NailsonChagas/EEG/imgs_slide/kicaf_canal.jpeg

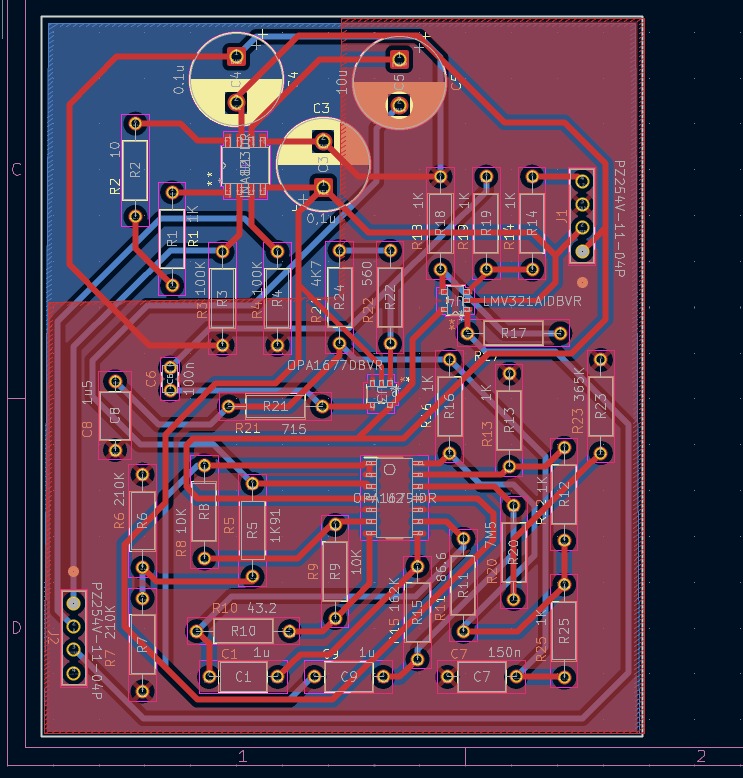
imgs_slide/kicaf_canal.jpeg
