NailsonChagas/EEG/imgs_slide/easyeda_canal.jpeg

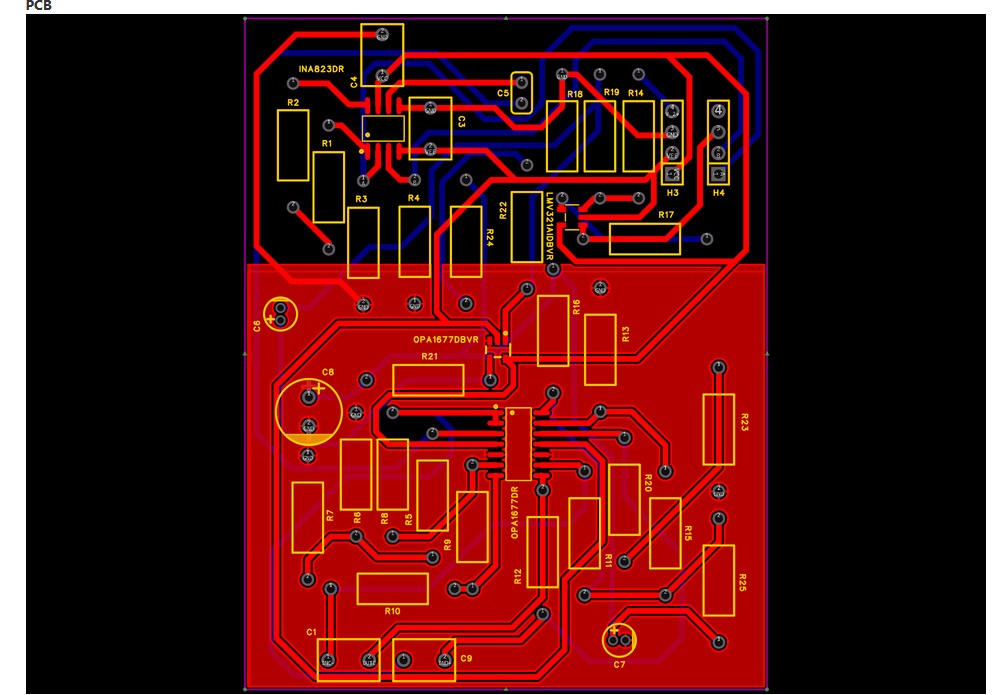
imgs_slide/easyeda_canal.jpeg
