NailsonChagas/EEG/EEG.drawio.png

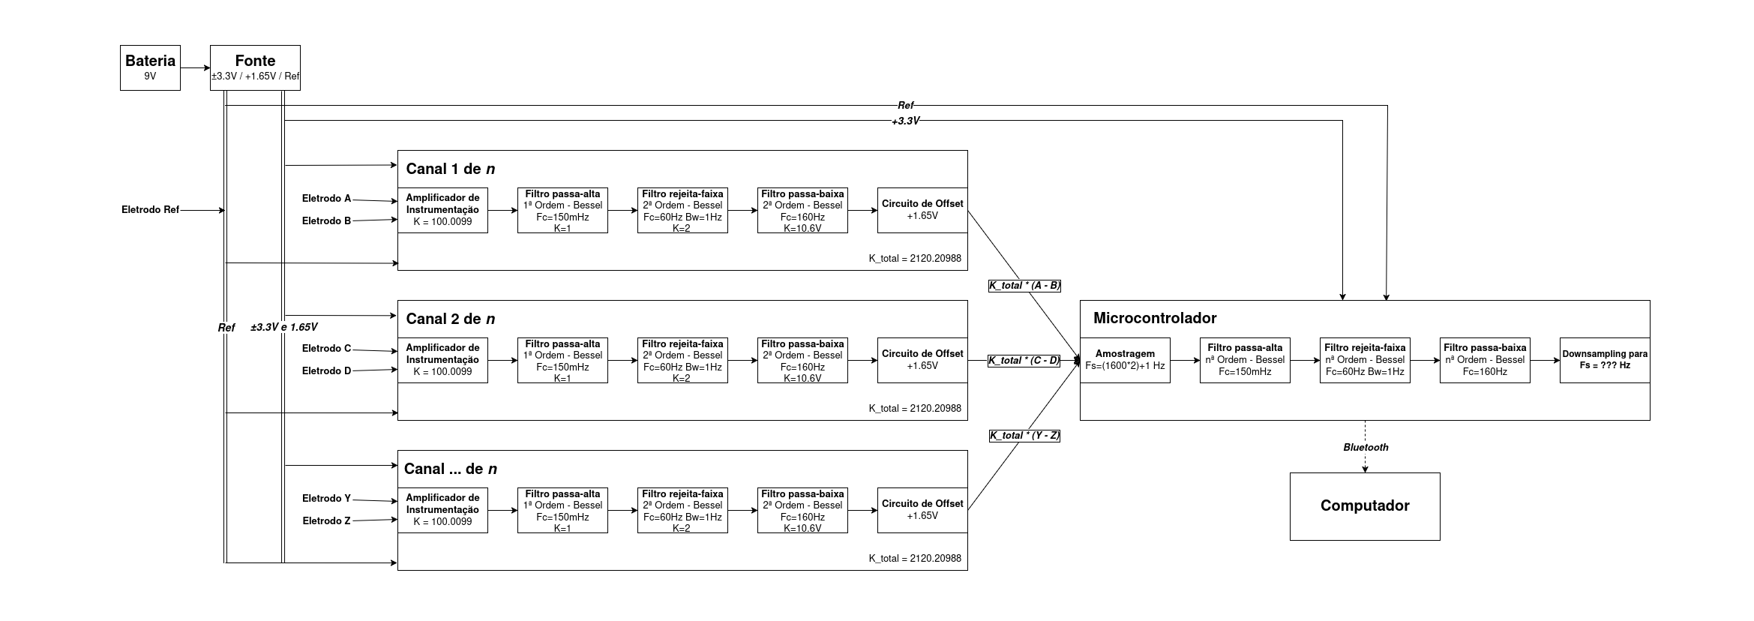
EEG.drawio.png
