NailsonChagas/EEG/imgs_slide/easyeda_fonte.jpeg

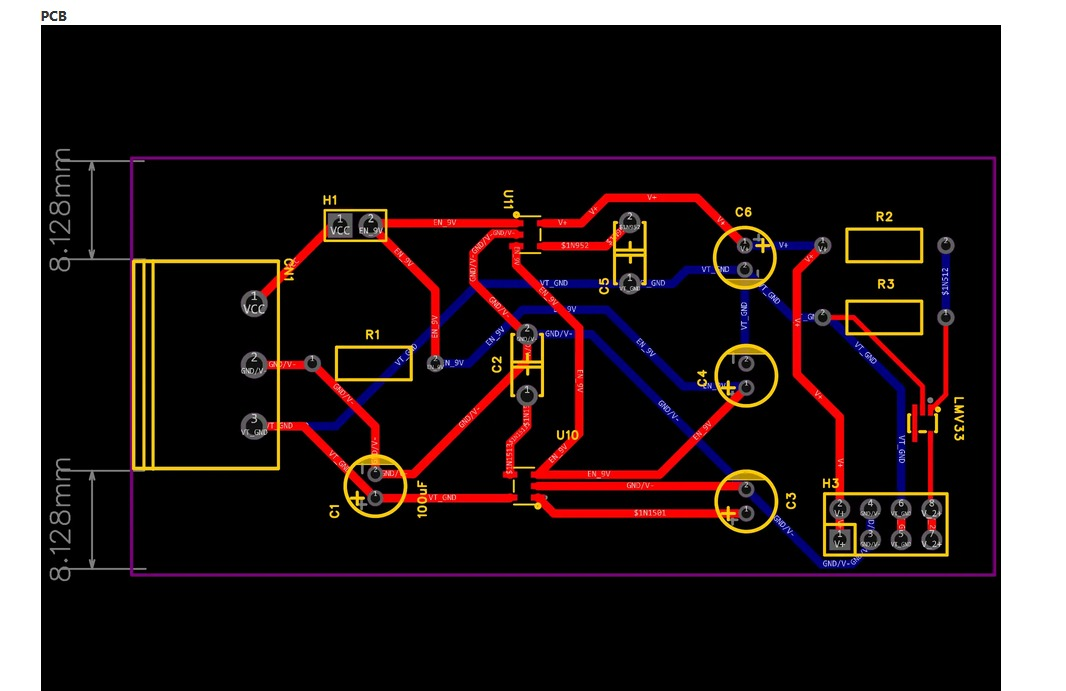
imgs_slide/easyeda_fonte.jpeg
