NailsonChagas/EEG/imgs_slide/fase_sim_canal_sub.png

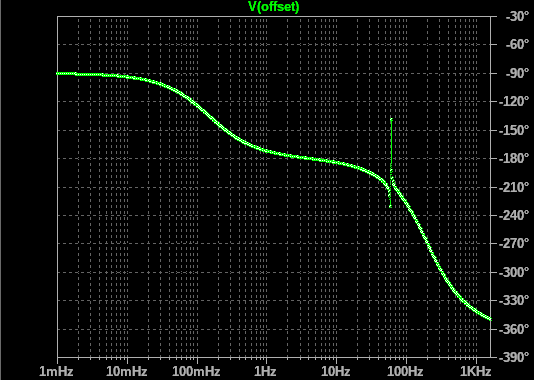
imgs_slide/fase_sim_canal_sub.png
