NailsonChagas/EEG/imgs_slide/fonte_pcb.png

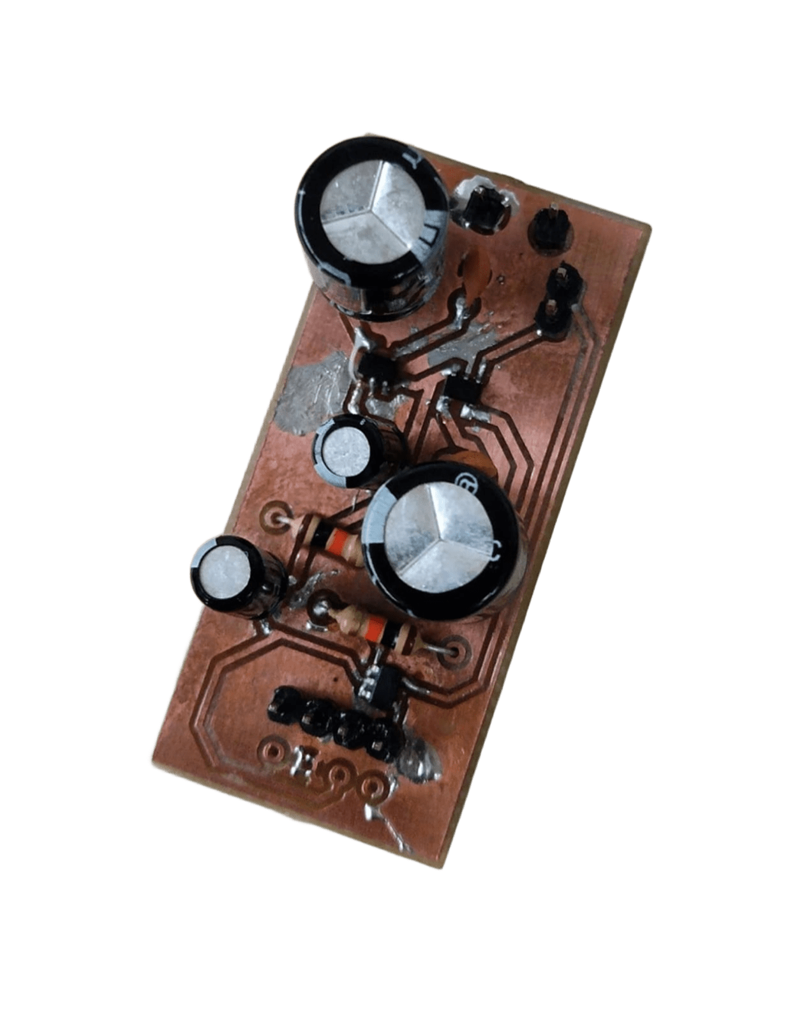
imgs_slide/fonte_pcb.png
