NailsonChagas/EEG/imgs_slide/kicad_fonte.jpeg

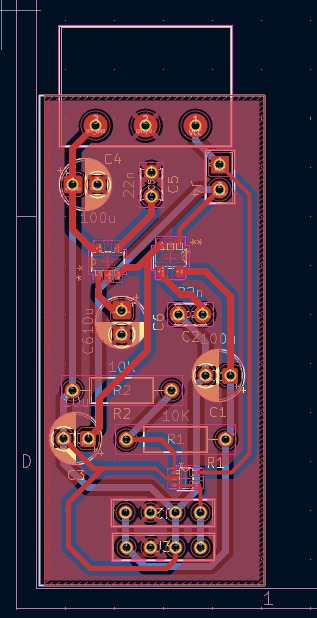
imgs_slide/kicad_fonte.jpeg
