NailsonChagas/EEG/imgs_slide/mag_sim_canal_sub.png

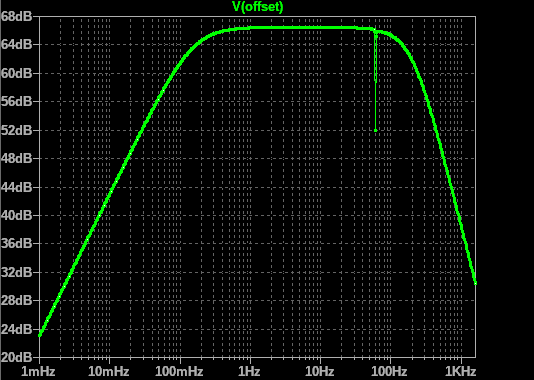
imgs_slide/mag_sim_canal_sub.png
