NailsonChagas/EEG/imgs_slide/original_fase.png

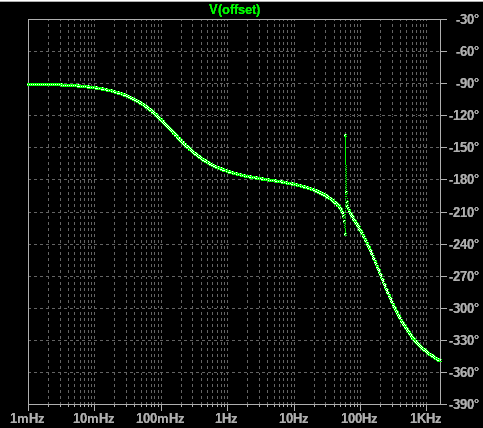
imgs_slide/original_fase.png
