NailsonChagas/EEG/imgs_slide/original_mag.png

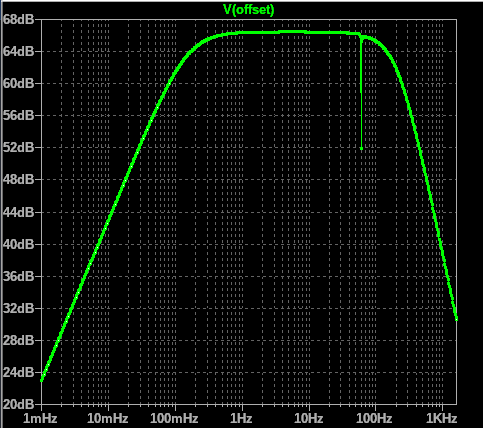
imgs_slide/original_mag.png
