NailsonChagas/EEG/imgs_slide/plot_ruido_ambiente.png

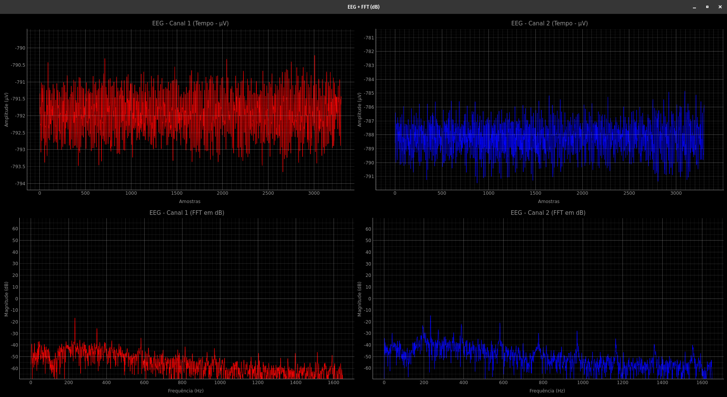
imgs_slide/plot_ruido_ambiente.png
