NailsonChagas/EEG/imgs_slide/start_plot.png

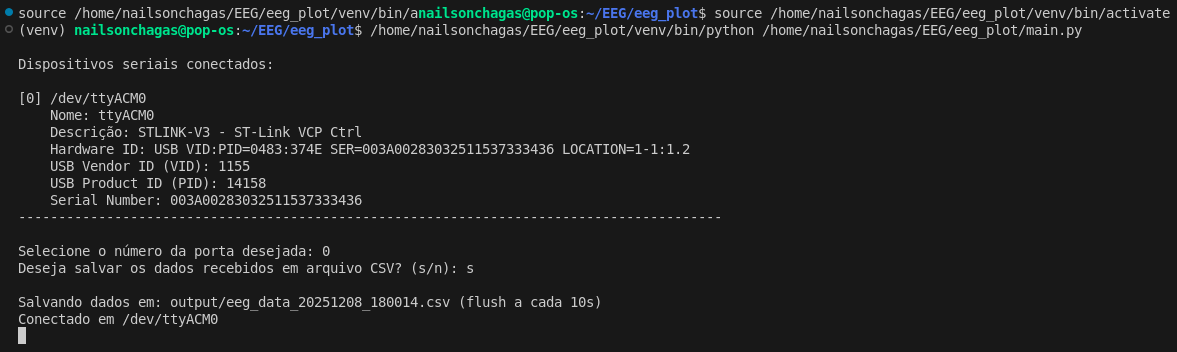
imgs_slide/start_plot.png
