NailsonChagas/EEG/lista_materiais.md

# Lista de Materiais
https://octopart.com/

## Fonte -> Atualizar
| Quantidade | Componente |
|---|---|
| 2 | LT1117-3.3 |
| 1 | Bateria 9V |
| 2 | Capacitor eletrolítico 10µF |
| 2 | Capacitor eletrolítico 100µF |
| 2 | Resistor 10kΩ |
| 1 | OpAmp (a definir) |
| 1 | Eletrodo (Ref) |

## Canal (para cada canal)

### 1 - Amplificador de Instrumentação
| Quantidade | Componente |
|---|---|
| 2 | Eletrodo (A e B) |
| 1 | INA823 |
| 2 | Resistor 100kΩ |
| 1 | Resistor 1.01kΩ |
| 2 | Capacitor cerâmico 0.1µF (100nF)  |

### 2 - Filtro Passa Alta
| Quantidade | Componente |
|---|---|
| 1 | Capacitor cerâmico 10µF |
| 1 | Resistor 107kΩ |
| 1 | OpAmp OPA167x |

### 3 - Filtro Rejeita Faixa
| Quantidade | Componente |
|---|---|
| 3 | OpAmp OPA167x |
| 1 | Resistor 43.2Ω |
| 1 | Resistor 86.6Ω |
| 2 | Resistor 1kΩ |
| 2 | Resistor 10kΩ |
| 1 | Resistor 162kΩ |
| 1 | Resistor 7.87MΩ |
| 2 | Capacitor cerâmico 1µF |

### 4 - Filtro Passa Baixa
| Quantidade | Componente |
|---|---|
| 1 | Resistor 499Ω |
| 1 | Resistor 715Ω |
| 1 | Resistor 5.23kΩ |
| 1 | Capacitor cerâmico 1.62µF |
| 1 | Capacitor cerâmico 0.1µF (100nF)  |
| 1 | OpAmp OPA167x |

### 5 - Circuito de Offset
| Quantidade | Componente |
|---|---|
| 1 | OpAmp LMC648x |
| 4 | Resistor 1kΩ |

### Materiais do canal p/ canal
| Quantidade | Componente | 
|---|---|
| 2 | Eletrodo (A e B) |
| 1 | INA823 |
| 5 | OpAmp OPA167x |
| 1 | OpAmp LMC648x |
| 1 | Resistor 43.2Ω |
| 1 | Resistor 86.6Ω |
| 1 | Resistor 499Ω |
| 1 | Resistor 715Ω |
| 6 | Resistor 1kΩ |
| 1 | Resistor 1.01kΩ |
| 1 | Resistor 5.23kΩ |
| 2 | Resistor 10kΩ |
| 2 | Resistor 100kΩ |
| 1 | Resistor 107kΩ |
| 1 | Resistor 162kΩ |
| 1 | Resistor 7.87MΩ |
| 3 | Capacitor cerâmico 0.1µF (100nF)  |
| 2 | Capacitor cerâmico 1µF |
| 1 | Capacitor cerâmico 1.62µF |
| 1 | Capacitor cerâmico 10µF |
