NailsonChagas/EEG/PCB-Kicad/LT1677CS8_TRPBF/LT1677CS8_TRPBF.step

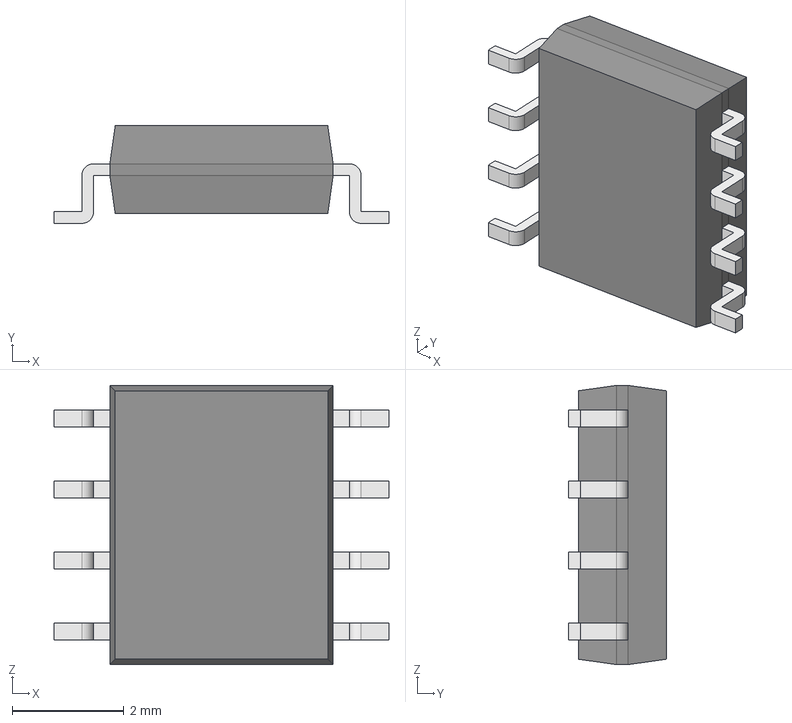
[picture p13: CAD file, 2025-12-13]
PCB-Kicad/LT1677CS8_TRPBF/LT1677CS8_TRPBF.step
6.00 x 1.75 x 5.00 mm
Body001 (Mirror #1) x 4
XY-plane x 12
X-axis x 12
