NailsonChagas/EEG/canal_e_fonte/canal_com_fonte_freq_teste_nai.asc

C1: cap; 1µ
C2: cap; 1µ
C3: cap; 10µ
C6: cap; 100n
C7: cap; 1.62µ
C9: polcap; 100µ
C11: cap; 1µ
C12: cap; 1µ
C15: polcap; 10µ
C18: polcap; 1000µ
C19: polcap; 10µ
R1: res; 1.01k
R2: res; 107k
R3: res; 100k
R4: res; 100k
R7: res; 10k
R11: res; 715
R12: res; 499
R13: res; 5.23k
R16: res; 10k
R20: res; 10k
R21: res; 10k
R22: res; 43.2
R23: res; 162k
R24: res; 86.6
R25: res; 7.87Meg
R26: res; 1k
R27: res; 1k
R37: res; 1k
R38: res; 1k
R40: res; 1k
R41: res; 1k
U1: INA823
U2: OPA167x_D
U3: LT1117-3.3
U4: OPA167x_D
U5: LT1677
U6: OPA167x_D
U7: OPA167x_D
U8: LT1117-3.3
U9: OPA167x_D
U11: LT1677
V1: signal; SINE(0 800u 100); AC 1
V2: voltage; 9
Named nets: 0, EletrodoA, EletrodoB, InAmp, V-, V+, HP150m, Notch60, LP160, offset, V_2+
K = 1 + (100k / Rg) p/ K = 100.0099 Rg = 1.01k
AMPLIFICADOR DE INSTRUMENTAÇÃO
.ac dec 100 0.001 1600
High-Pass; 1st order Bessel; 150mHz passband; 
Optimize: Noise; +Vs: 3.3; -Vs: -3.3; GBW comp
Analog Filter Wizard
Bandstop Filter- 2nd order Bessel  Passband:
Ao: 1.000 V/V, Fc: 60 Hz, BWp: 1 Hz, Rp: 1.000 dB
Stopband:
BWs: 100 mHz, Asb: -40.00 dB, Gain 2V/V
TI Filter Design Tool
Lowpass Filter- 2nd order Bessel
Passband: Ao: 10.60 V/V, Fp: 160 Hz, Rp: 1.000 dB
Stopband: Fs: 1.6 kHz, Asb: -40.00 dB
Multiple feedback - TI filter design tool
Offset de 1.65V para remover a parte negativa
Fonte simétrica +-3.3V usando ground virtual
Alimentado por bateria de 9V
FONTE
CANAL
