NailsonChagas/EEG/canal_e_fonte/canal_ltspice_teste/canal.asc

C1: cap; 0.1µ
C2: cap; 0.1µ
C3: cap; 10µ
C6: cap; 100n
C7: cap; 1.65µ
C11: cap; 1µ
C12: cap; 1µ
R1: res; 1.01k
R3: res; 1k
R4: res; 1k
R5: res; 100k
R6: res; 100k
R7: res; 210k
R8: res; 210k
R9: res; 1910
R11: res; 715
R13: res; 5260
R20: res; 10k
R21: res; 10k
R22: res; 43.2
R23: res; 162k
R24: res; 86.6
R25: res; 7.865Meg
R26: res; 1k
R27: res; 1k
R37: res; 1k
R38: res; 1k
R40: res; 1k
R41: res; 1k
U1: INA823
U2: OPA167x_D
U4: OPA167x_D
U5: lmv321a
U6: OPA167x_D
U7: OPA167x_D
U9: OPA167x_D
V1: signal; SINE(0 800u 100); AC 1
V2: voltage; 3.3
V3: voltage; 3.3
V4: voltage; 1.65
Named nets: EletrodoA, EletrodoB, InAmp, V-, V+, 0, HP150m, Notch60, LP160, offset, V_2+
K = 1 + (100k / Rg) p/ K = 100.0099 Rg = 1.01k
AMPLIFICADOR DE INSTRUMENTAÇÃO
.ac dec 100 0.001 1600
High-Pass; 1st order Bessel; 150mHz passband; 
Optimize: Noise; +Vs: 3.3; -Vs: -3.3; GBW comp
Analog Filter Wizard
Bandstop Filter- 2nd order Bessel  Passband:
Ao: 1.000 V/V, Fc: 60 Hz, BWp: 1 Hz, Rp: 1.000 dB
Stopband:
BWs: 100 mHz, Asb: -40.00 dB, Gain 2V/V
TI Filter Design Tool
Lowpass Filter- 2nd order Bessel
Passband: Ao: 10.60 V/V, Fp: 160 Hz, Rp: 1.000 dB
Stopband: Fs: 1.6 kHz, Asb: -40.00 dB
Multiple feedback - TI filter design tool
Offset de 1.65V para remover a parte negativa
Simulando uma Fonte simétrica +-3.3V usando ground virtual
Alimentado por bateria de 9V
CANAL
.tran 0 0.15 0.1
AD8613 tbm funciona
