NailsonChagas/EEG/canal_e_fonte/fonte_ltspice/fonte.asc

C9: polcap; 100µ
C15: polcap; 10µ
C18: polcap; 100µ
C19: polcap; 10µ
R7: res; 10k
R16: res; 10k
U1: lmv331
U3: LT1117-3.3
U8: LT1117-3.3
V2: voltage; 9
Named nets: 0, V-, V+, V_2+
.tran 0 0.15 0.1
Fonte simétrica +-3.3V usando ground virtual
Alimentado por bateria de 9V
FONTE
Usar o RT9193-33GB
