NailsonChagas/EEG/(list of files, drawings)

Other design files:
PCB-EasyEDA/ProPrj_EEG_2025-12-13.epro
