NailsonChagas/EEG/PCB-Kicad/EEG_Kicad/Canal/Cnal+Fonte/Cnal+Fonte.kicad_pcb

## KiCad design PCB-Kicad/EEG_Kicad/Canal/Cnal+Fonte/Cnal+Fonte.kicad_pcb (2025-12-13)

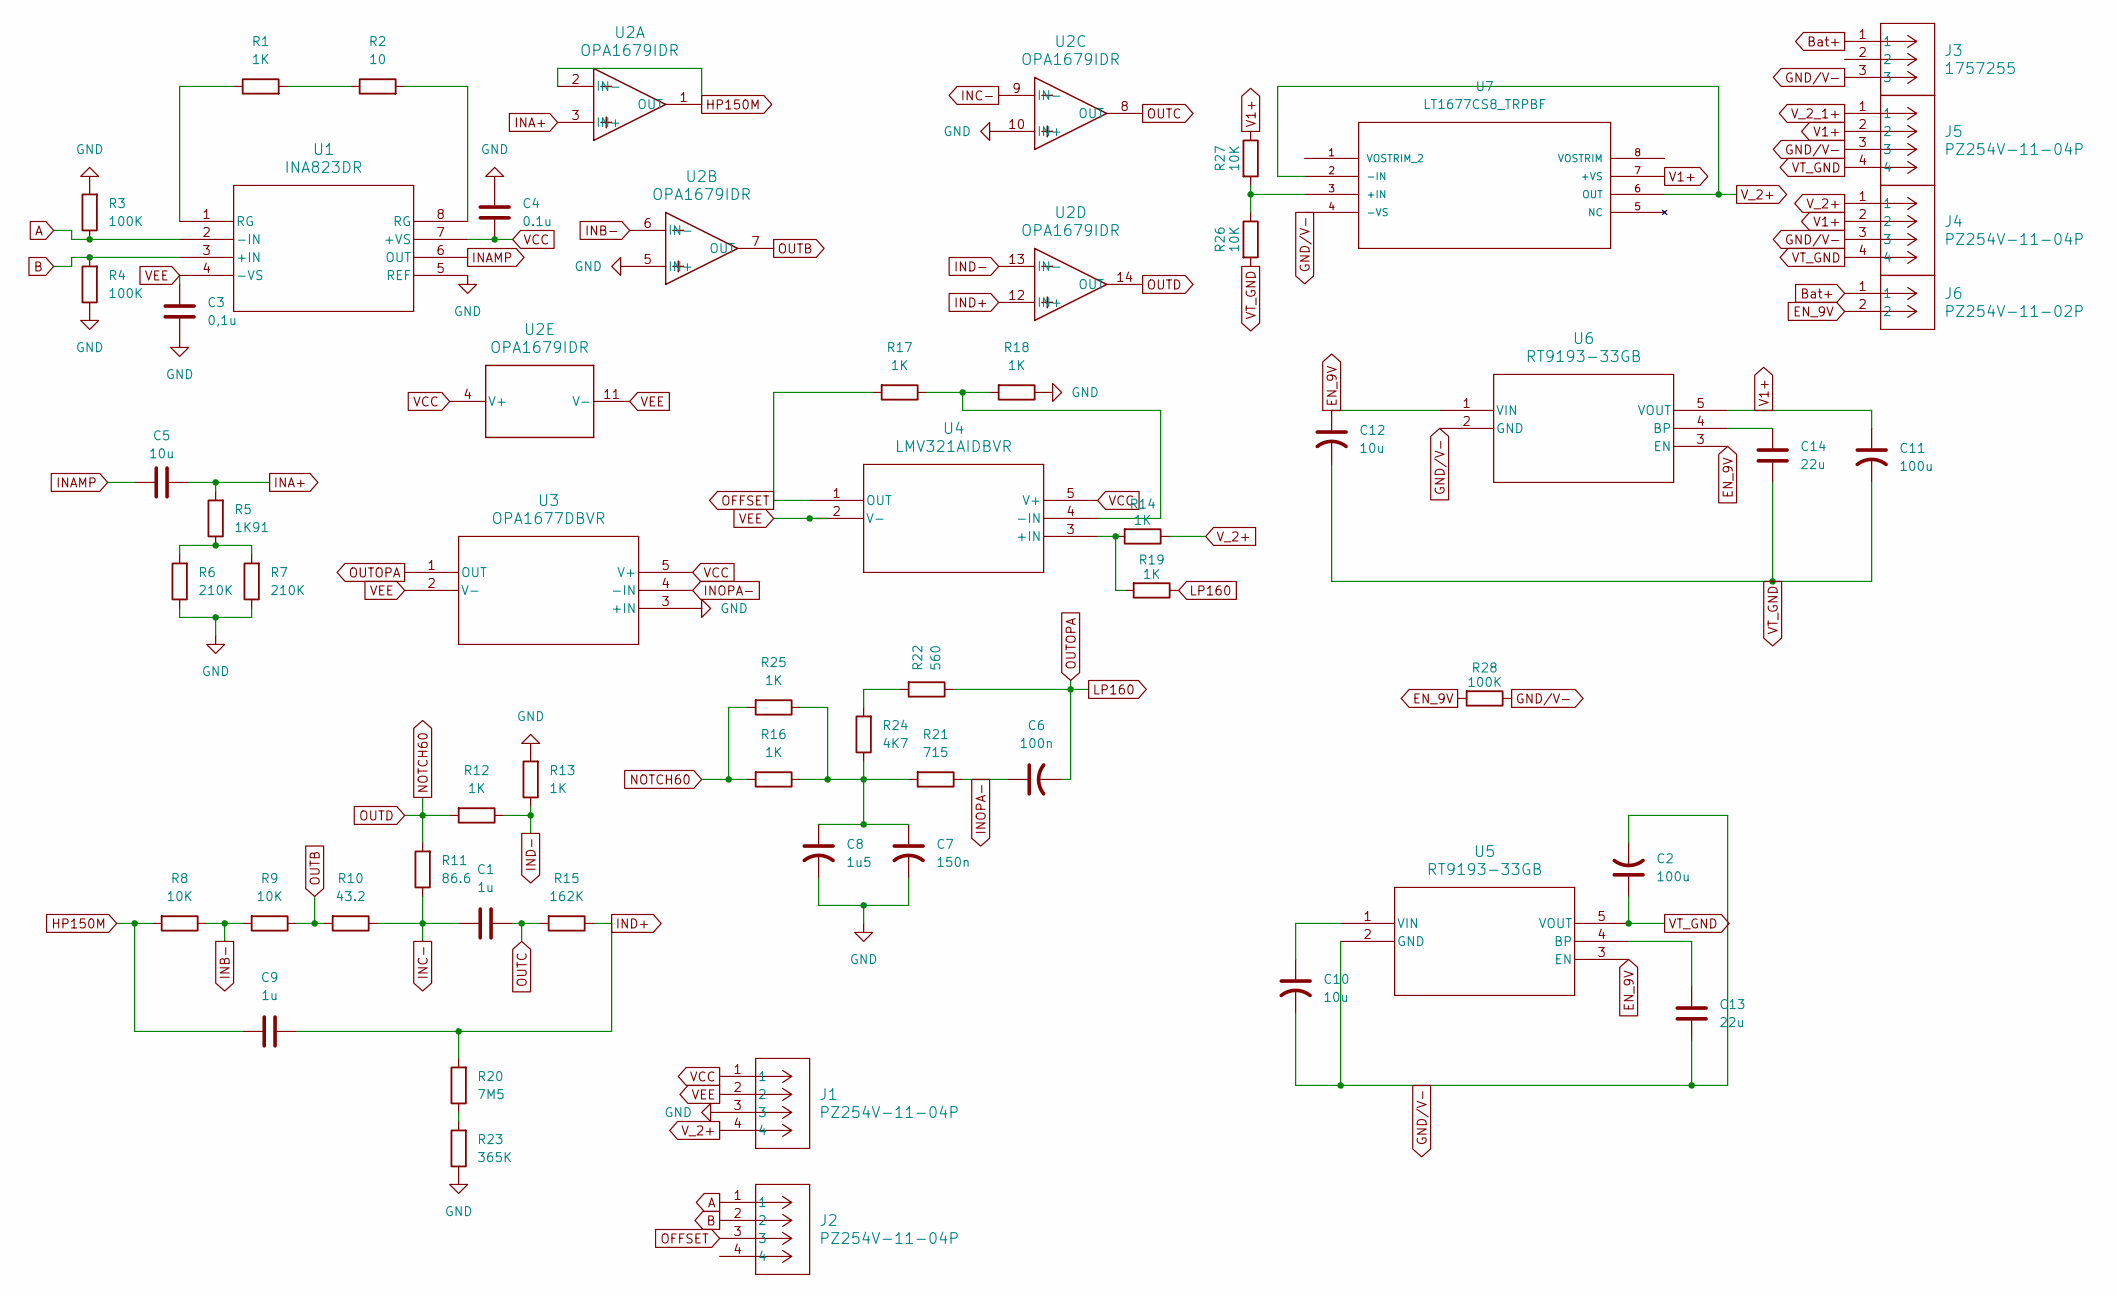
[picture p14: schematic Cnal+Fonte.kicad_sch]

Parts:
C1, C9: 1u; C_Axial_L5.1mm_D3.1mm_P7.50mm_Horizontal
C2, C11: 100u; C_Disc_D3.0mm_W1.6mm_P2.50mm
C3: 0,1u; CP_Radial_D10.0mm_P5.00mm
C4: 0.1u; CP_Radial_D10.0mm_P5.00mm
C5: 10u; CP_Radial_D10.0mm_P5.00mm
C6: 100n; C_Disc_D3.0mm_W1.6mm_P2.50mm
C7: 150n; C_Axial_L5.1mm_D3.1mm_P7.50mm_Horizontal
C8: 1u5; C_Axial_L5.1mm_D3.1mm_P7.50mm_Horizontal
C10, C12: 10u; C_Disc_D3.0mm_W1.6mm_P2.50mm
C13, C14: 22u; C_Axial_L5.1mm_D3.1mm_P7.50mm_Horizontal
J1, J2, J4, J5: PZ254V-11-04P; CONN_PZ254V-11-04P_XFC
J3: 1757255; CONN_1757255_PXC
J6: PZ254V-11-02P; CONN_PZ254V-11-02P_02P_XFC
R1, R12, R13, R14, R16, R17, R18, R19, R25: 1K; R_Axial_DIN0207_L6.3mm_D2.5mm_P10.16mm_Horizontal
R2: 10; R_Axial_DIN0207_L6.3mm_D2.5mm_P10.16mm_Horizontal
R3, R4, R28: 100K; R_Axial_DIN0207_L6.3mm_D2.5mm_P10.16mm_Horizontal
R5: 1K91; R_Axial_DIN0207_L6.3mm_D2.5mm_P10.16mm_Horizontal
R6, R7: 210K; R_Axial_DIN0207_L6.3mm_D2.5mm_P10.16mm_Horizontal
R8, R9, R26, R27: 10K; R_Axial_DIN0207_L6.3mm_D2.5mm_P10.16mm_Horizontal
R10: 43.2; R_Axial_DIN0207_L6.3mm_D2.5mm_P10.16mm_Horizontal
R11: 86.6; R_Axial_DIN0207_L6.3mm_D2.5mm_P10.16mm_Horizontal
R15: 162K; R_Axial_DIN0207_L6.3mm_D2.5mm_P10.16mm_Horizontal
R20: 7M5; R_Axial_DIN0207_L6.3mm_D2.5mm_P10.16mm_Horizontal
R21: 715; R_Axial_DIN0207_L6.3mm_D2.5mm_P10.16mm_Horizontal
R22: 560; R_Axial_DIN0207_L6.3mm_D2.5mm_P10.16mm_Horizontal
R23: 365K; R_Axial_DIN0207_L6.3mm_D2.5mm_P10.16mm_Horizontal
R24: 4K7; R_Axial_DIN0207_L6.3mm_D2.5mm_P10.16mm_Horizontal
U1: INA823DR; D0008A_SOIC_TEX
U2: OPA1679IDR; D0014A_N
U3: OPA1677DBVR; SOT23_DBV0005A_TEX
U4: LMV321AIDBVR; DBV5_TEX
U5, U6: RT9193-33GB; SOT-23-5_RIT
U7: LT1677CS8_TRPBF; SO-8_S; MANUFACTURER_PART_NUMBER lt1677cs8

Connections:
A: J2.1, R3.1, U1.2 (-IN)
B: J2.2, R4.2, U1.3 (+IN)
Bat+: J3.1, J6.1
EN_9V: C12.1, J6.2, R28.2, U5.3 (EN), U6.1 (VIN), U6.3 (EN)
GND: C3.2, C4.1, C7.2, C8.2, J1.3, R3.2, R4.1, R6.1, R7.1, R13.2, R18.1, R23.1, U1.5 (REF), U2.5 (IN+), U2.10 (IN+), U3.3 (+IN)
GND/V-: C2.2, C10.2, C13.2, J3.3, J4.3, J5.3, R28.1, U5.2 (GND), U6.2 (GND), U7.4 (-VS)
HP150M: C9.2, R8.2, U2.1 (OUT), U2.2 (IN-)
INA+: C5.2, R5.2, U2.3 (IN+)
INAMP: C5.1, U1.6 (OUT)
INB-: R8.1, R9.2, U2.6 (IN-)
INC-: C1.2, R10.1, R11.1, U2.9 (IN-)
IND+: C9.1, R15.1, R20.2, U2.12 (IN+)
IND-: R12.1, R13.1, U2.13 (IN-)
INOPA-: C6.1, R21.1, U3.4 (-IN)
LP160: C6.2, R19.1, R22.1, U3.1 (OUT)
NOTCH60: R11.2, R12.2, R16.2, R25.2, U2.14 (OUT)
unnamed: C7.1, C8.1, R16.1, R21.2, R24.1, R25.1
unnamed: R1.1, U1.1 (RG)
unnamed: R1.2, R2.1
unnamed: R2.2, U1.8 (RG)
unnamed: R5.1, R6.2, R7.2
unnamed: R20.1, R23.2
unnamed: R22.2, R24.2
unnamed: R14.2, R19.2, U4.3 (+IN)
unnamed: R17.1, R18.2, U4.4 (-IN)
unnamed: C13.1, U5.4 (BP)
unnamed: C10.1, U5.1 (VIN)
unnamed: C14.1, U6.4 (BP)
unnamed: R26.1, R27.2, U7.3 (+IN)
OFFSET: J2.3, R17.2, U4.1 (OUT)
OUTB: R9.1, R10.2, U2.7 (OUT)
OUTC: C1.1, R15.2, U2.8 (OUT)
V1+: C11.1, J4.2, J5.2, R27.1, U6.5 (VOUT), U7.7 (+VS)
VCC: C4.2, J1.1, U1.7 (+VS), U2.4 (V+), U3.5 (V+), U4.5 (V+)
VEE: C3.1, J1.2, U1.4 (-VS), U2.11 (V-), U3.2 (V-), U4.2 (V-)
VT_GND: C2.1, C11.2, C12.2, C14.2, J4.4, J5.4, R26.2, U5.5 (VOUT)

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
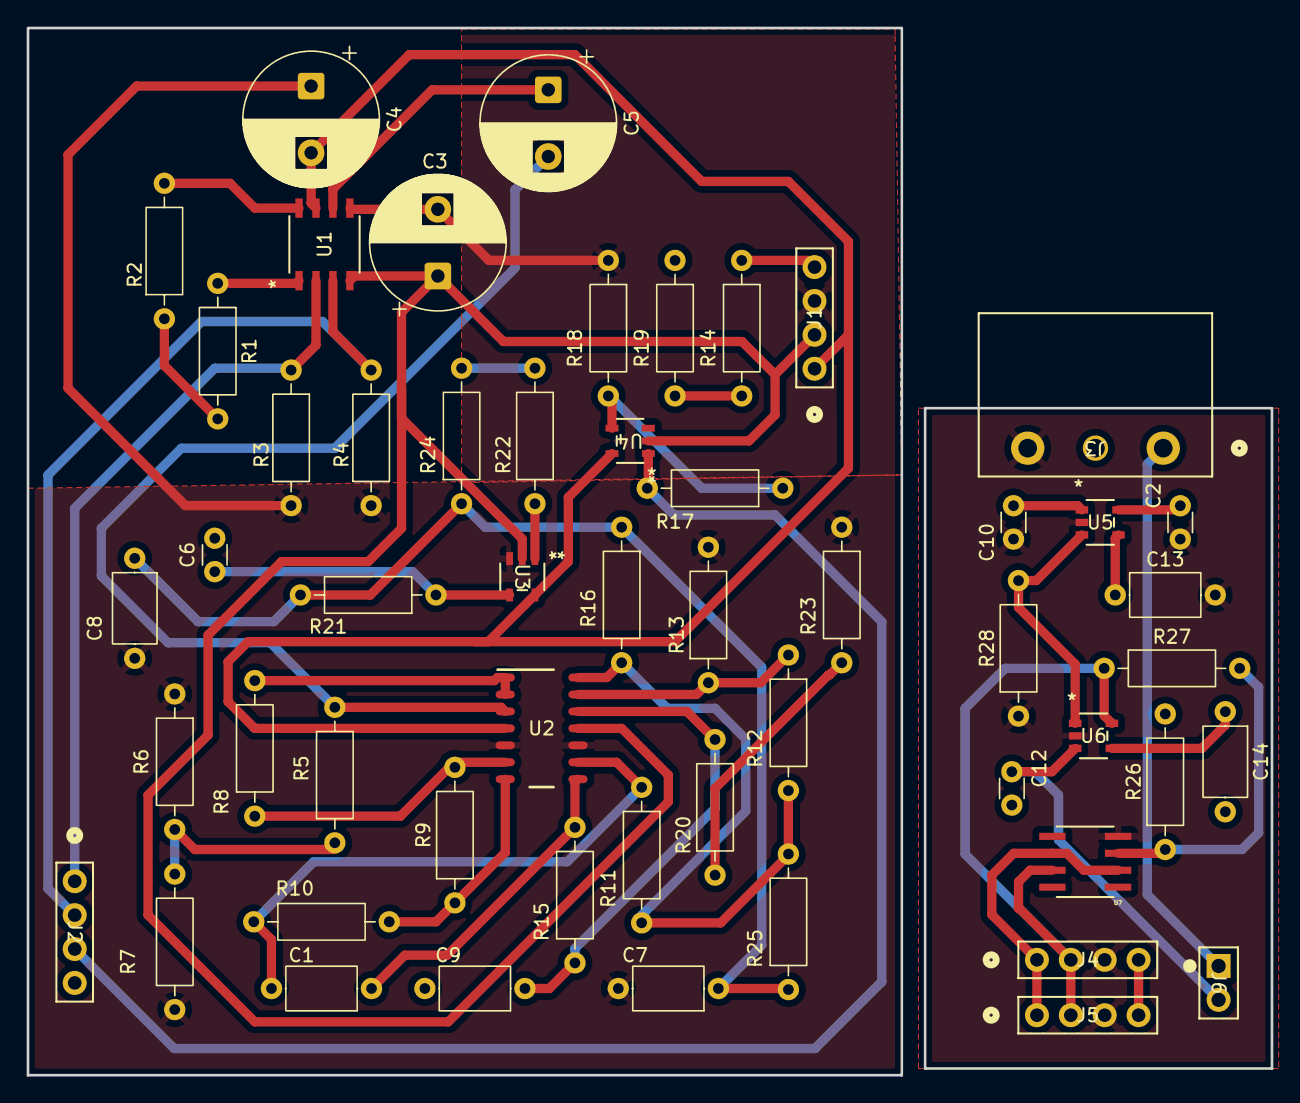
[picture p15: board Cnal+Fonte.kicad_pcb from above]

Board: 2 copper layers, 93.2 x 78.5 mm, 54 parts (0 on the bottom side), 38 nets.
