NailsonChagas/EEG/PCB-Kicad/EEG_Kicad/Fonte/Fonte.kicad_pcb

## KiCad design PCB-Kicad/EEG_Kicad/Fonte/Fonte.kicad_pcb (2025-12-13)

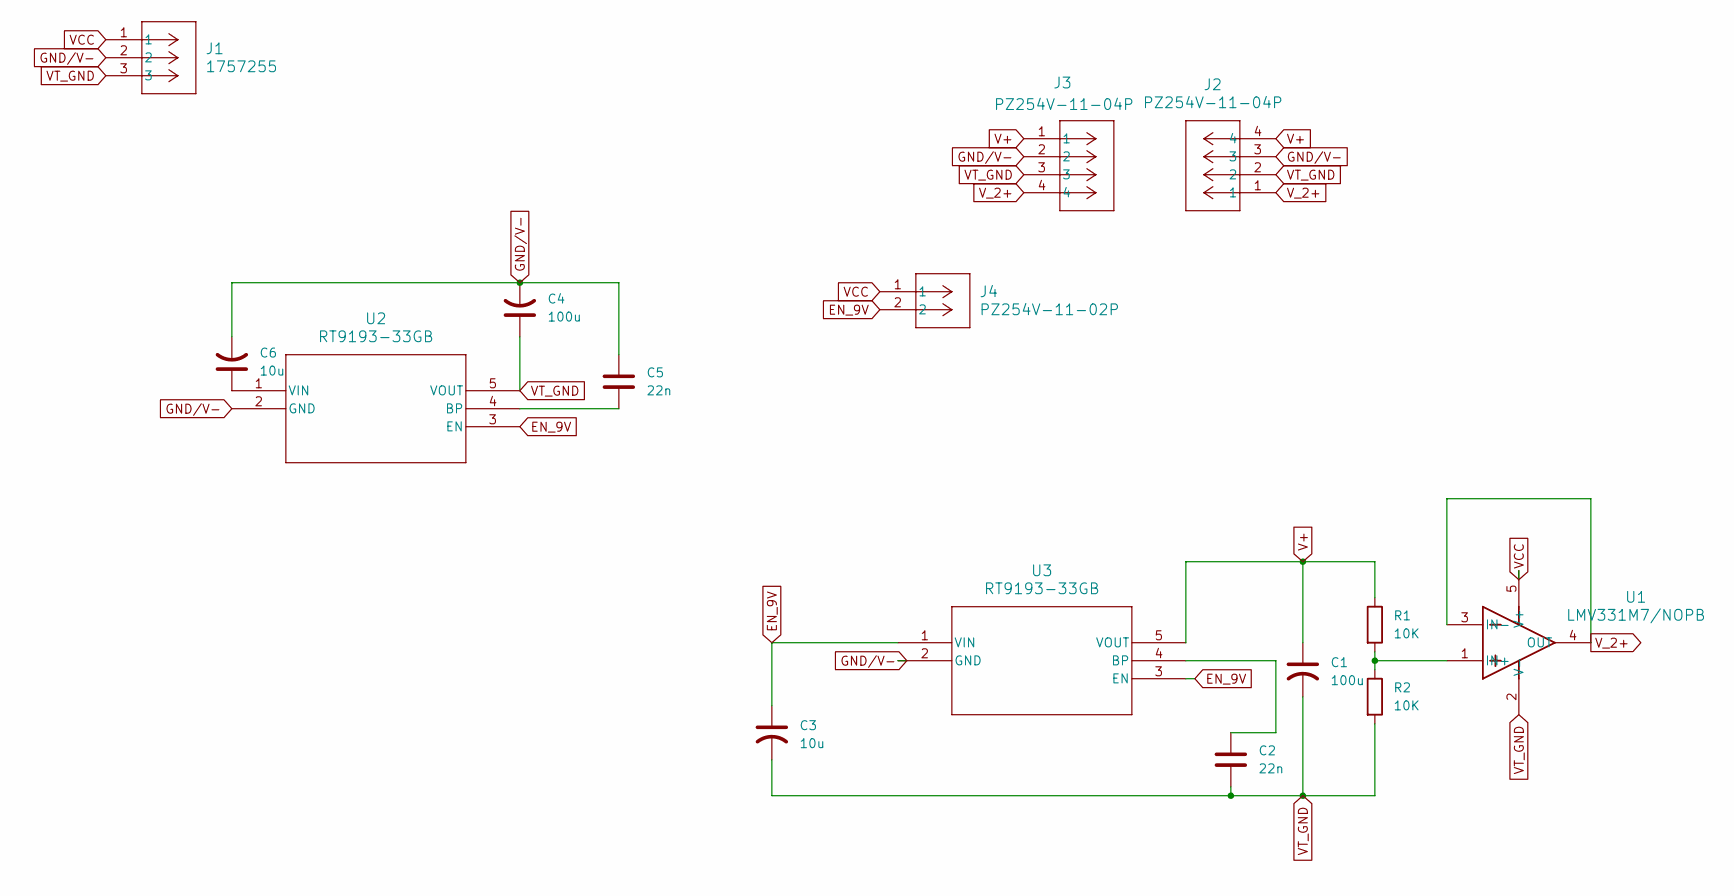
[picture p16: schematic Fonte.kicad_sch]

Parts:
C1, C4: 100u; CP_Radial_D5.0mm_P2.50mm
C2, C5: 22n; C_Disc_D3.0mm_W2.0mm_P2.50mm
C3, C6: 10u; CP_Radial_D5.0mm_P2.50mm
J1: 1757255; CONN_1757255_PXC
J2, J3: PZ254V-11-04P; CONN_PZ254V-11-04P_XFC
J4: PZ254V-11-02P; CONN_PZ254V-11-02P_02P_XFC
R1, R2: 10K; R_Axial_DIN0207_L6.3mm_D2.5mm_P10.16mm_Horizontal
U1: LMV331M7/NOPB; MAA05A
U2, U3: RT9193-33GB; SOT-23-5_RIT

Connections:
EN_9V: C3.1, J4.2, U2.3 (EN), U3.1 (VIN), U3.3 (EN)
GND/V-: C4.2, C5.1, C6.2, J1.2, J2.3, J3.2, U2.2 (GND), U3.2 (GND)
unnamed: R1.2, R2.1, U1.1 (IN+)
unnamed: C5.2, U2.4 (BP)
unnamed: C6.1, U2.1 (VIN)
unnamed: C2.1, U3.4 (BP)
V+: C1.1, J2.4, J3.1, R1.1, U3.5 (VOUT)
VCC: J1.1, J4.1, U1.5 (V+)
VT_GND: C1.2, C2.2, C3.2, C4.1, J1.3, J2.2, J3.3, R2.2, U1.2 (V-), U2.5 (VOUT)
V_2+: J2.1, J3.4, U1.3 (IN-), U1.4 (OUT)

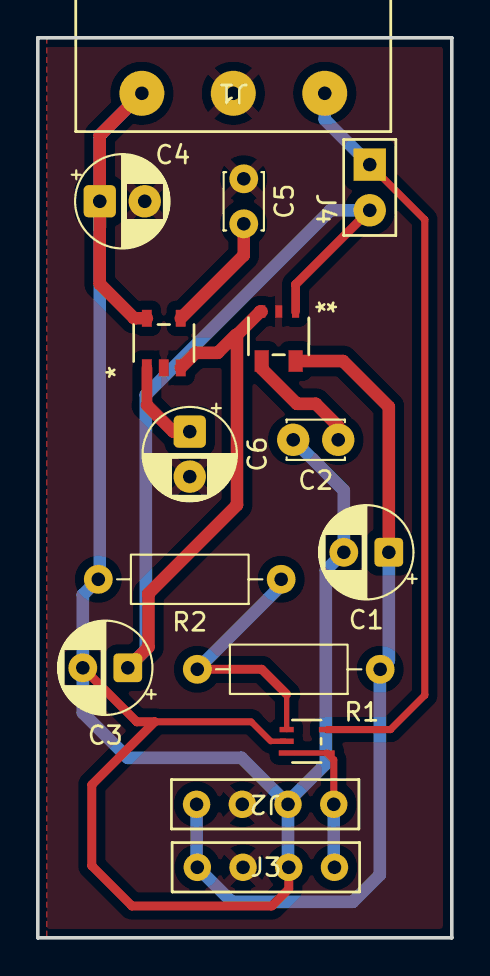
[picture p17: board Fonte.kicad_pcb from above]

Board: 2 copper layers, 23.0 x 50.0 mm, 15 parts (0 on the bottom side), 10 nets.
