NailsonChagas/EEG/firmware/EEG/Core/Src/main.c

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
/* Includes ------------------------------------------------------------------*/
#include "main.h"
#include "cmsis_os.h"

/* USER CODE BEGIN Includes */
#include "filter.h"
/* USER CODE END Includes */

/* USER CODE BEGIN PTD */
typedef struct {
	float ch1;
	float ch2;
} FilteredData;
/* USER CODE END PTD */

/* USER CODE BEGIN PD */
// Constantes usadas
#define FS 3302.0f  // frequência de amostragem do sinal

// Conversão do AD
#define NUMBER_OF_AQ 1
#define NUMBER_OF_AD 2
#define ADC12_TO_VOLTAGE 0.000805861
#define ADC16_TO_VOLTAGE 0.000050355

// Configurações do filtro notch
#define FC_NOTCH 60.0f    // frequência central rejeitada
#define BW 1.0f     // largura de banda

// Filtro passa baixa
#define FC_LP 160.0f
#define Q 0.707f

/* USER CODE END PD */

ADC_HandleTypeDef hadc1;
ADC_HandleTypeDef hadc2;
DMA_HandleTypeDef hdma_adc1;

UART_HandleTypeDef hlpuart1;

TIM_HandleTypeDef htim2;

osThreadId FilterTaskHandle;
/* USER CODE BEGIN PV */
// como é alocada para o DMA n precisa ser volatile (https://community.st.com/t5/stm32-mcus-embedded-software/should-dma-variables-be-volatile/td-p/794260)
uint16_t adc_dual_buffer[NUMBER_OF_AQ * NUMBER_OF_AD];
BiquadFilter notch_filter_AD1, notch_filter_AD2, lp_filter_AD1, lp_filter_AD2;
volatile float filtered_ad1, filtered_ad2;
SemaphoreHandle_t sem_uart = NULL;
SemaphoreHandle_t sem_ad = NULL;
QueueHandle_t queue_tx = NULL;
TimerHandle_t btn_c13_debounce;
volatile uint8_t is_low_power_mode = 0;

volatile uint32_t teste = 0;
/* USER CODE END PV */

void SystemClock_Config(void);
static void MX_GPIO_Init(void);
static void MX_DMA_Init(void);
static void MX_ADC1_Init(void);
static void MX_ADC2_Init(void);
static void MX_TIM2_Init(void);
static void MX_LPUART1_UART_Init(void);
void StartFilterTask(void const * argument);

/* USER CODE BEGIN PFP */
void check_status(HAL_StatusTypeDef status);

// FreeRTOS config param: USE_IDLE_HOOK enable
void vApplicationIdleHook(void)
{
    if (!is_low_power_mode)   // só usar no modo automático
    {
    	// Wait For Interrupt
        // garante que acorda via ADC, UART, EXTI, etc
        __WFI();   // CPU entra em sleep até próxima interrupção
    }
}

void init_adc_tim2(void)
{
	HAL_ADCEx_Calibration_Start(&hadc1, ADC_SINGLE_ENDED);
	HAL_ADCEx_Calibration_Start(&hadc2, ADC_SINGLE_ENDED);

	check_status(HAL_ADC_Start(&hadc2));
	check_status(
			HAL_ADCEx_MultiModeStart_DMA(&hadc1, (uint32_t*) adc_dual_buffer,
			NUMBER_OF_AQ));

	HAL_TIM_Base_Start(&htim2);
}

/*
 * toggle_power_mode():
 *
 * Alterna entre modo normal e modo de baixo consumo (STOP1).
 *
 * Quando entra em STOP1:
 * - Marca que está em low-power.
 * - Para temporizadores, ADCs e DMA para reduzir consumo.
 * - Desabilita clocks dos ADCs e DMA.
 * - Limpa e habilita EXTI para permitir despertar por interrupção.
 * - Suspende o SysTick (economia extra).
 * - Entra em STOP1 (CPU dorme até interrupção).
 *
 * Ao acordar do STOP1:
 * - Retoma SysTick.
 *
 * Quando retorna ao modo normal:
 * - Marca que saiu do low-power.
 * - Reconfigura o clock (essencial após STOP).
 * - Reabilita clocks dos periféricos.
 * - Recalibra e reinicia ADCs + DMA.
 * - Reinicia temporizador.
 */
void toggle_power_mode(void)
{
	if (!is_low_power_mode)
	    {
	        is_low_power_mode = 1;

	        // parar timers, ADCs, UART, DMA (para economizar energia)
	        HAL_TIM_Base_Stop(&htim2);
	        HAL_ADC_Stop_DMA(&hadc1);
	        HAL_ADC_Stop(&hadc2);

	        __HAL_RCC_ADC12_CLK_DISABLE();
	        __HAL_RCC_DMA1_CLK_DISABLE();

	        // Limpa interrupções pendentes
	        __HAL_GPIO_EXTI_CLEAR_IT(GPIO_PIN_13);

	        // Habilita EXTI para acordar
	        HAL_NVIC_EnableIRQ(EXTI15_10_IRQn);

	        // Entra em modo STOP1
	        HAL_SuspendTick();   // reduz consumo
	        // Sem SysTick não existe troca de contexto -> FreeRTOS congela
	        HAL_PWREx_EnterSTOP1Mode(PWR_STOPENTRY_WFI);

	        // ---- quando acordar do STOP, continua daqui ----
	        HAL_ResumeTick();
	    }
	    else
	    {
	        is_low_power_mode = 0;

	        SystemClock_Config();   // STOP destrói o clock -> iniciar de novo

	        __HAL_RCC_DMA1_CLK_ENABLE();
	        __HAL_RCC_ADC12_CLK_ENABLE();

	        // reconfigura ADC + DMA
	        init_adc_tim2();
	    }
}

void btn_c13_callback(TimerHandle_t xTimer)
{
	// entrar/sair de Low Power Mode
	toggle_power_mode();
	HAL_NVIC_EnableIRQ(EXTI15_10_IRQn);  // Reabilita interrupções
}

void HAL_GPIO_EXTI_Callback(uint16_t GPIO_Pin)
{
	if(GPIO_Pin == GPIO_PIN_13)
	{
		BaseType_t pxHigherPriorityTaskWoken = pdFALSE;
		HAL_NVIC_DisableIRQ(EXTI15_10_IRQn);  // Desabilita interrupções
		xTimerStartFromISR(btn_c13_debounce, &pxHigherPriorityTaskWoken);
		portYIELD_FROM_ISR(pxHigherPriorityTaskWoken);
	}
}


void HAL_ADC_ConvCpltCallback(ADC_HandleTypeDef *hadc) {
	// Ao ler AD abre o semaforo
	BaseType_t xHigherPriorityTaskWoken = pdFALSE;
	xSemaphoreGiveFromISR(sem_ad, &xHigherPriorityTaskWoken);
	portYIELD_FROM_ISR(xHigherPriorityTaskWoken);
}

void HAL_UART_TxCpltCallback(UART_HandleTypeDef *huart) {
	BaseType_t pxHigherPriorityTaskWoken = pdFALSE;
	xSemaphoreGiveFromISR(sem_uart, &pxHigherPriorityTaskWoken);
	portYIELD_FROM_ISR(pxHigherPriorityTaskWoken); //
}

void SendDataTask(void *param) {
	FilteredData ad_data;
	const uint8_t start = '$';
	const uint8_t end = '\n';
	const uint8_t uint8_size = sizeof(uint8_t);
	const uint8_t data_block_size = sizeof(FilteredData);

	while (1) {
		if (xQueueReceive(queue_tx, &ad_data, portMAX_DELAY) == pdPASS) {
			HAL_UART_Transmit(&hlpuart1, &start, uint8_size, HAL_MAX_DELAY);
			HAL_UART_Transmit(&hlpuart1, (uint8_t*) &ad_data, data_block_size,
					HAL_MAX_DELAY);
			HAL_UART_Transmit(&hlpuart1, &end, uint8_size, HAL_MAX_DELAY);
			teste++;
		}
		taskYIELD();
	}
}

/* USER CODE END PFP */

/**
  * @brief  The application entry point.
  * @retval int
  */
int main(void)
{

  /* MCU Configuration--------------------------------------------------------*/

  /* Reset of all peripherals, Initializes the Flash interface and the Systick. */
  HAL_Init();

  /* Configure the system clock */
  SystemClock_Config();

  /* Initialize all configured peripherals */
  MX_GPIO_Init();
  MX_DMA_Init();
  MX_ADC1_Init();
  MX_ADC2_Init();
  MX_TIM2_Init();
  MX_LPUART1_UART_Init();
  /* USER CODE BEGIN 2 */

	init_notch_filter(&notch_filter_AD1, FS, FC_NOTCH, BW);
	init_notch_filter(&notch_filter_AD2, FS, FC_NOTCH, BW);

	init_lp_filter(&lp_filter_AD1, FS, FC_LP, Q);
	init_lp_filter(&lp_filter_AD2, FS, FC_LP, Q);

	init_adc_tim2();

  /* USER CODE END 2 */

  /* USER CODE BEGIN RTOS_MUTEX */
	/* add mutexes, ... */
  /* USER CODE END RTOS_MUTEX */

  /* USER CODE BEGIN RTOS_SEMAPHORES */
	/* add semaphores, ... */
	sem_uart = xSemaphoreCreateBinary();
	sem_ad = xSemaphoreCreateBinary();
  /* USER CODE END RTOS_SEMAPHORES */

  /* USER CODE BEGIN RTOS_TIMERS */
	/* start timers, add new ones, ... */
	btn_c13_debounce = xTimerCreate("BTN13 debounce", 50, pdFALSE, NULL, btn_c13_callback);
  /* USER CODE END RTOS_TIMERS */

  /* USER CODE BEGIN RTOS_QUEUES */
	/* add queues, ... */
	queue_tx = xQueueCreate(32, sizeof(FilteredData));
  /* USER CODE END RTOS_QUEUES */

  /* Create the thread(s) */
  /* definition and creation of FilterTask */
  osThreadDef(FilterTask, StartFilterTask, osPriorityAboveNormal, 0, 256);
  FilterTaskHandle = osThreadCreate(osThread(FilterTask), NULL);

  /* USER CODE BEGIN RTOS_THREADS */
	/* add threads, ... */
	xTaskCreate(SendDataTask, "SendData", 256, NULL, 0, NULL);
  /* USER CODE END RTOS_THREADS */

  /* Start scheduler */
  osKernelStart();

  /* We should never get here as control is now taken by the scheduler */

  /* Infinite loop */
  /* USER CODE BEGIN WHILE */
	while (1) {
    /* USER CODE END WHILE */

    /* USER CODE BEGIN 3 */
	}
  /* USER CODE END 3 */
}

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
/* USER CODE BEGIN 4 */
void check_status(HAL_StatusTypeDef status) {
	if (status != HAL_OK)
		Error_Handler();
}

/* USER CODE END 4 */

/* USER CODE BEGIN Header_StartFilterTask */
/**
 * @brief  Function implementing the FilterTask thread.
 * @param  argument: Not used
 * @retval None
 */
/* USER CODE END Header_StartFilterTask */
void StartFilterTask(void const * argument)
{
  /* USER CODE BEGIN 5 */
	/* Infinite loop */
	for (;;) {
		// se estiver aberto pega para si e fecha
		xSemaphoreTake(sem_ad, portMAX_DELAY);
		float ad1 = adc_dual_buffer[0] * ADC12_TO_VOLTAGE;
		float ad2 = adc_dual_buffer[1] * ADC12_TO_VOLTAGE;

		filtered_ad1 = apply_filter(&notch_filter_AD1, ad1);
		filtered_ad2 = apply_filter(&notch_filter_AD2, ad2);
		filtered_ad1 = apply_filter(&lp_filter_AD1, filtered_ad1);
		filtered_ad2 = apply_filter(&lp_filter_AD2, filtered_ad2);

		FilteredData data = { filtered_ad1, filtered_ad2 };
		xQueueSend(queue_tx, &data, 0);
	}
  /* USER CODE END 5 */
}

/**
  * @brief  Period elapsed callback in non blocking mode
  * @note   This function is called  when TIM17 interrupt took place, inside
  * HAL_TIM_IRQHandler(). It makes a direct call to HAL_IncTick() to increment
  * a global variable "uwTick" used as application time base.
  * @param  htim : TIM handle
  * @retval None
  */
void HAL_TIM_PeriodElapsedCallback(TIM_HandleTypeDef *htim)
{
  if (htim->Instance == TIM17)
  {
    HAL_IncTick();
  }
}

/**
  * @brief  This function is executed in case of error occurrence.
  * @retval None
  */
void Error_Handler(void)
{
  /* USER CODE BEGIN Error_Handler_Debug */
	/* User can add his own implementation to report the HAL error return state */
	__disable_irq();
	while (1) {
	}
  /* USER CODE END Error_Handler_Debug */
}
#ifdef USE_FULL_ASSERT
/**
  * @brief  Reports the name of the source file and the source line number
  *         where the assert_param error has occurred.
  * @param  file: pointer to the source file name
  * @param  line: assert_param error line source number
  * @retval None
  */
void assert_failed(uint8_t *file, uint32_t line)
{
  /* USER CODE BEGIN 6 */
  /* User can add his own implementation to report the file name and line number,
     ex: printf("Wrong parameters value: file %s on line %d\r\n", file, line) */
  /* USER CODE END 6 */
}
#endif /* USE_FULL_ASSERT */
