NailsonChagas/EEG/firmware/EEG/EEG.ioc

Mcu.UserName=STM32G431RBTx
PA0.Signal=ADC1_IN1
PA1.Signal=ADC2_IN2
PA13.Signal=SYS_JTMS-SWDIO
PA14.Signal=SYS_JTCK-SWCLK
PA2.Signal=LPUART1_TX
PA3.Signal=LPUART1_RX
PC13.Signal=GPXTI13
PF0-OSC_IN.Signal=RCC_OSC_IN
PF1-OSC_OUT.Signal=RCC_OSC_OUT
