NailsonChagas/EEG/(commit log)

2025-04-06 feat: adicionando os modelos dos amplificadores de instrumentação que estamos estudando se podemos usar no desenvolviemnto do canal
    [INA819.OLB, INA819_Test_Circuit.DSN, INA819_Test_Circuit.OPJ, INA823.OLB, INA823_Test_Circuit.DSN, INA823_Test_Circuit.OPJ, INA849.OLB, INA849_Test_Circuit.DSN]
2025-04-16 feat: colocando os requirimentos para executar o script python
2025-04-30 feat: filtro 60hz
2025-05-05 filtro de 60Hz
2025-05-14 feat: filtro 160Hz
2025-06-12 feat: filtro de quarto grau
2025-07-22 feat: removendo componentes não usados e arrumando caminhos absolutos
    [INA819.OLB, INA819_Test_Circuit.DSN, INA819_Test_Circuit.OPJ, INA823.OLB, INA823_Test_Circuit.DSN, INA823_Test_Circuit.OPJ, INA849.OLB, INA849_Test_Circuit.DSN]
2025-07-24 feat: fonte funcionado, falta o divisor de tensão
2025-09-09 feat: separando as pastas e fazendo lista de materiais
2025-09-18 feat: atualizando lista de materiais
2025-11-04 feat: plot em tempo real dos canais, falta a conversão para o valor real
2025-11-05 feat: organizando o código de plot
2025-11-05 fix: atualizando arquivo requisitos e adicionando um tratamento para caso n ache dispositivos seriais
    [main.py]
2025-11-06 feat: mudando a ordem para organizar
2025-11-06 feat: atualizando versão do stm32cudeIDE
2025-11-17 feat: leitura do botão que irá ser responsavel por fazer entrar/sair de low power mode
2025-11-17 feat: modos de baixo consumo
2025-11-17 feat: como valor é trocado dentro de uma interrupção deve ser volatile
